hotchk155/gate_boost/gate_boost.sch

## EAGLE design gate_boost.sch (2019-02-27)

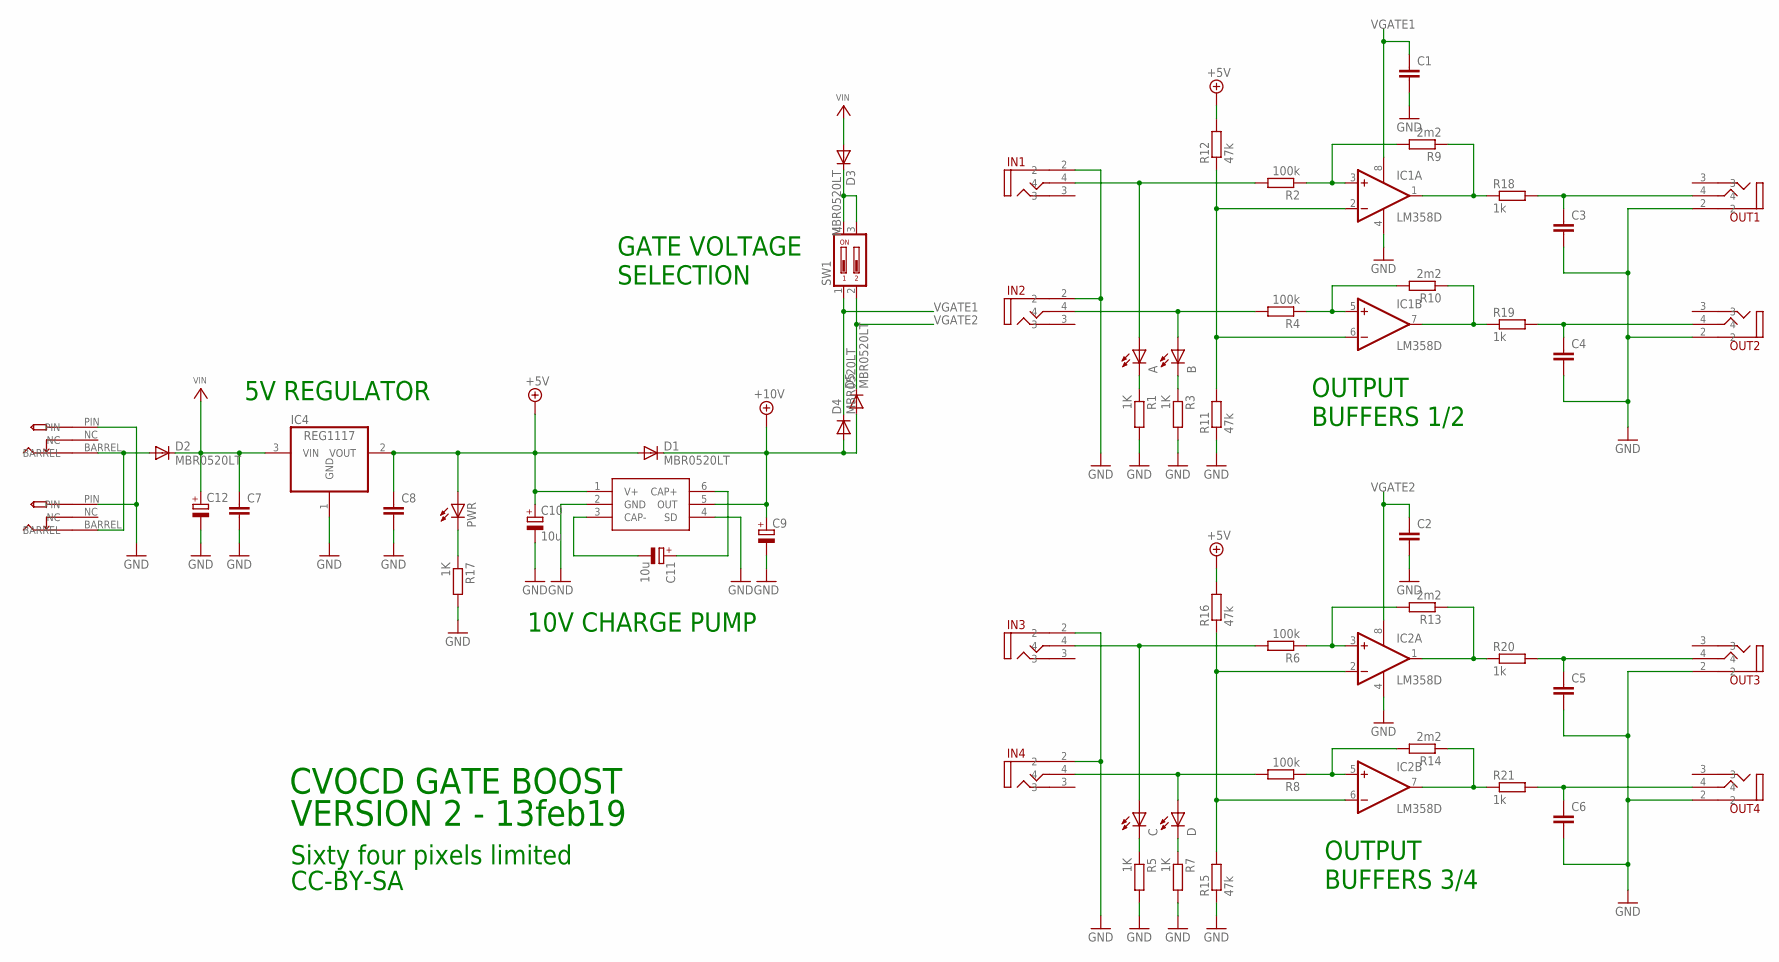
[picture p1: schematic gate_boost.sch]

Parts:
A: LED3MM
B: LED3MM
C: LED3MM
C1, C2, C3, C4, C5, C6, C7, C8: C-EUC0805; C0805
C9: CPOL-EUSMCA; SMC_A
C10, C11: 10u; SMC_A
C12: CPOL-EUE2-5; E2-5
D: LED3MM
D1, D2, D3, D4, D5: MBR0520LT; SOD123
IC1, IC2: LM358D; SO08
IC3: LM27675M5_CHARGEPUMP; SOT23-6
IC4: REG1117; SOT223
IN1, IN2, IN3, IN4: VERTICAL_3_5MM_SOCKET
OUT1, OUT2, OUT3, OUT4: VERTICAL_3_5MM_SOCKET
PWR: LED3MM
R1, R3, R5, R7, R17: 1K; R0805
R2, R4, R6, R8: 100k; R0805
R9, R10, R13, R14: 2m2; R0805
R11, R12, R15, R16: 47k; R0805
R18, R19, R20, R21: 1k; R0805
SW1: DIP02YL
U$1, U$2: PWR_SOCKET_2_1MM

Connections:
+5V: C8.1, C10.+, D1.A, IC3.1 (V+), IC4.2 (VOUT), PWR.A, R12.2, R16.2
+10V: C9.+, D1.C, D4.A, D5.A, IC3.5 (OUT)
GND: C1.2, C2.2, C3.2, C4.2, C5.2, C6.2, C7.2, C8.2, C9.-, C10.-, C12.-, IC1.4 (V-), IC2.4 (V-), IC3.2 (GND), IC3.4 (SD), IC4.1 (GND), IN1.2, IN2.2, IN3.2, IN4.2, OUT1.2, OUT2.2, OUT3.2, OUT4.2, R1.2, R3.2, R5.2, R7.2, R11.1, R15.1, R17.2, U$1.PIN, U$2.PIN
IN1: A.A, IN1.4, R2.2
IN2: B.A, IN2.4, R4.2
IN3: C.A, IN3.4, R6.2
IN4: D.A, IN4.4, R8.2
unnamed: IC1.2 (-IN), IC1.6 (-IN), R11.2, R12.1
unnamed: A.K (C), R1.1
unnamed: B.K (C), R3.1
unnamed: IC1.3 (+IN), R2.1, R9.2
unnamed: IC1.5 (+IN), R4.1, R10.2
unnamed: D3.C, SW1.3, SW1.4
unnamed: C5.1, OUT3.4, R20.2
unnamed: C6.1, OUT4.4, R21.2
unnamed: IC1.1 (OUT), R9.1, R18.1
unnamed: IC2.7 (OUT), R14.1, R21.1
unnamed: IC2.1 (OUT), R13.1, R20.1
unnamed: IC1.7 (OUT), R10.1, R19.1
unnamed: IC2.2 (-IN), IC2.6 (-IN), R15.2, R16.1
unnamed: C.K (C), R5.1
unnamed: D.K (C), R7.1
unnamed: IC2.3 (+IN), R6.1, R13.2
unnamed: IC2.5 (+IN), R8.1, R14.2
unnamed: C3.1, OUT1.4, R18.2
unnamed: C4.1, OUT2.4, R19.2
unnamed: D2.A, U$1.BARREL, U$2.BARREL
unnamed: PWR.K (C), R17.1
unnamed: C11.+, IC3.6 (CAP+)
unnamed: C11.-, IC3.3 (CAP-)
VGATE1: C1.1, D4.C, IC1.8 (V+), SW1.1
VGATE2: C2.1, D5.C, IC2.8 (V+), SW1.2
VIN: C7.1, C12.+, D2.C, D3.A, IC4.3 (VIN)

Notes on the sheet:
10V CHARGE PUMP
CVOCD GATE BOOST
VERSION 2 - 13feb19
Sixty four pixels limited
CC-BY-SA
5V REGULATOR
GATE VOLTAGE SELECTION
OUTPUT BUFFERS 1/2
OUTPUT BUFFERS 3/4
