hotchk155/gate_boost/stencil/gate_boost_stencil.brd

## EAGLE design stencil/gate_boost_stencil.brd (2019-03-22)

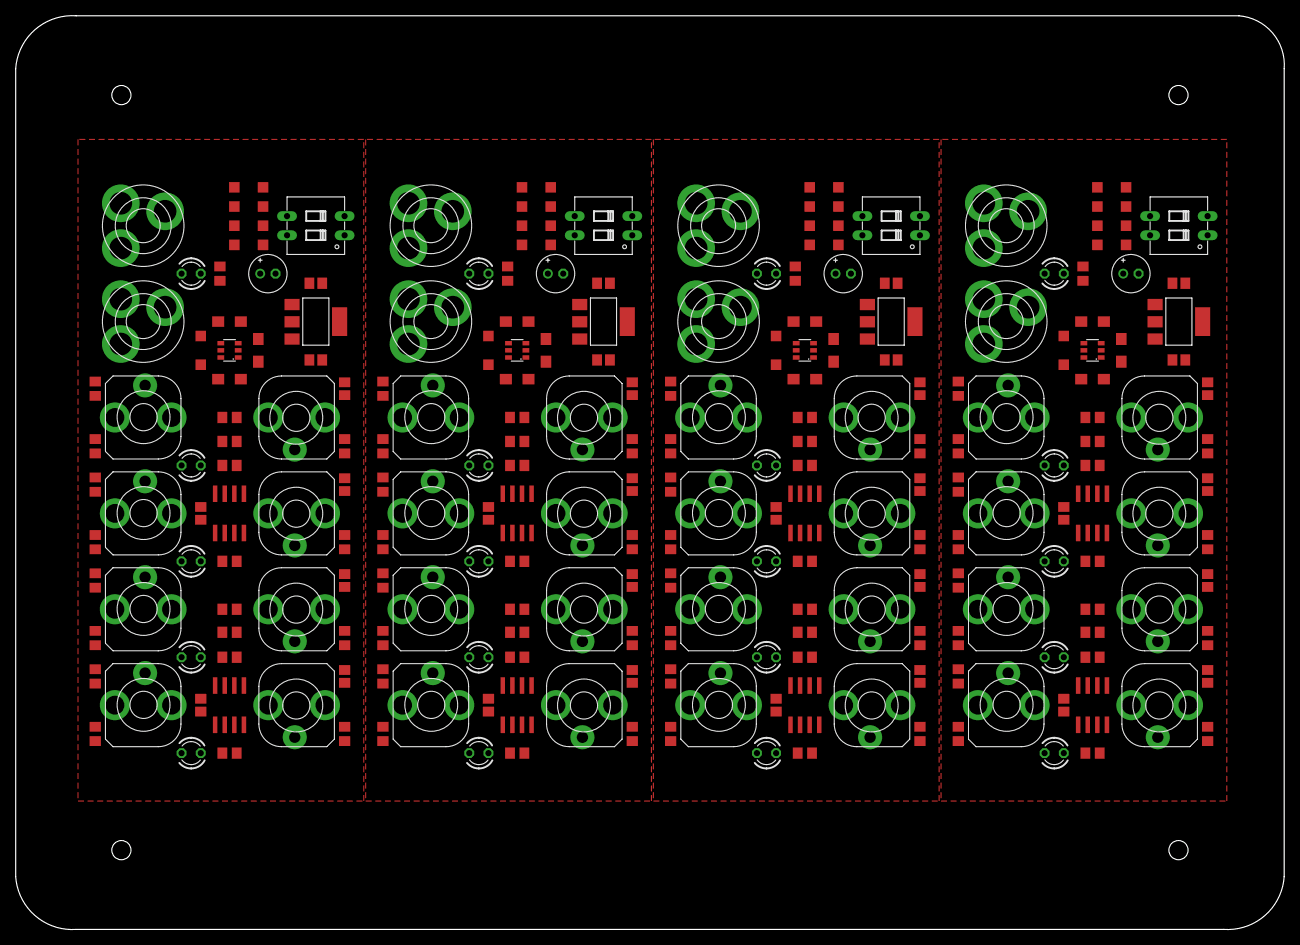
[picture p3: board gate_boost_stencil.brd from above]

Board: 2 copper layers, 168.0 x 121.0 mm, 236 parts (0 on the bottom side), 132 nets, no tracks yet.

Parts:
A, A1, A2, A3: LED3MM
B, B1, B2, B3: LED3MM
C, C19, C32, C45: LED3MM
C1, C2, C3, C4, C5, C6, C7, C8, C13, C14, C18, C20, C21, C22, C24, C25, C26, C27, C31, C33, C34, C35, C37, C38, C39, C40, C44, C46, C47, C48, C50, C51: C0805
C9, C16, C29, C42: SMC_A
C10, C11, C15, C17, C28, C30, C41, C43: 10u; SMC_A
C12, C23, C36, C49: E2-5
D, D7, D13, D19: LED3MM
D1, D2, D3, D4, D5, D6, D8, D9, D10, D11, D12, D14, D15, D16, D17, D18, D20, D21, D22, D23: MBR0520LT; SOD123
E$4, E$5, E$6, E$7: STENCILPIN
IC1, IC2, IC6, IC7, IC10, IC11, IC14, IC15: LM358D; SO08
IC3, IC5, IC9, IC13: LM27675M5_CHARGEPUMP; SOT23-6
IC4, IC8, IC12, IC16: REG1117; SOT223
IN1, IN2, IN3, IN4, IN5, IN6, IN7, IN8, IN9, IN10, IN11, IN12, IN13, IN14, IN15, IN16: VERTICAL_3_5MM_SOCKET
OUT1, OUT2, OUT3, OUT4, OUT5, OUT6, OUT7, OUT8, OUT9, OUT10, OUT11, OUT12, OUT13, OUT14, OUT15, OUT16: VERTICAL_3_5MM_SOCKET
PWR, PWR1, PWR2, PWR3: LED3MM
R1, R3, R5, R7, R17, R22, R23, R32, R33, R42, R43, R44, R53, R54, R63, R64, R65, R74, R75, R84: 1K; R0805
R2, R4, R6, R8, R28, R29, R38, R39, R49, R50, R59, R60, R70, R71, R80, R81: 100k; R0805
R9, R10, R13, R14, R30, R31, R40, R41, R51, R52, R61, R62, R72, R73, R82, R83: 2m2; R0805
R11, R12, R15, R16, R26, R27, R36, R37, R47, R48, R57, R58, R68, R69, R78, R79: 47k; R0805
R18, R19, R20, R21, R24, R25, R34, R35, R45, R46, R55, R56, R66, R67, R76, R77: 1k; R0805
SW1, SW2, SW3, SW4: DIP02YL
U$1, U$2, U$3, U$4, U$5, U$6, U$7, U$8: PWR_SOCKET_2_1MM

Connections:
+5V: C8.1, C10.+, D1.A, IC3.1, IC4.2, PWR.A, R12.2, R16.2
+5V1: C17.+, C25.1, D6.A, IC5.1, IC8.2, PWR1.A, R27.2, R37.2
+5V2: C30.+, C38.1, D12.A, IC9.1, IC12.2, PWR2.A, R48.2, R58.2
+5V3: C43.+, C51.1, D18.A, IC13.1, IC16.2, PWR3.A, R69.2, R79.2
+10V: C9.+, D1.C, D4.A, D5.A, IC3.5
+10V1: C16.+, D6.C, D9.A, D10.A, IC5.5
+10V2: C29.+, D12.C, D15.A, D16.A, IC9.5
+10V3: C42.+, D18.C, D21.A, D22.A, IC13.5
GND: C1.2, C2.2, C3.2, C4.2, C5.2, C6.2, C7.2, C8.2, C9.-, C10.-, C12.-, IC1.4, IC2.4, IC3.2, IC3.4, IC4.1, IN1.2, IN2.2, IN3.2, IN4.2, OUT1.2, OUT2.2, OUT3.2, OUT4.2, R1.2, R3.2, R5.2, R7.2, R11.1, R15.1, R17.2, U$1.PIN, U$2.PIN
GND1: C13.2, C14.2, C16.-, C17.-, C18.2, C20.2, C21.2, C22.2, C23.-, C24.2, C25.2, IC5.2, IC5.4, IC6.4, IC7.4, IC8.1, IN5.2, IN6.2, IN7.2, IN8.2, OUT5.2, OUT6.2, OUT7.2, OUT8.2, R22.2, R23.2, R26.1, R32.2, R33.2, R36.1, R42.2, U$3.PIN, U$4.PIN
GND2: C26.2, C27.2, C29.-, C30.-, C31.2, C33.2, C34.2, C35.2, C36.-, C37.2, C38.2, IC9.2, IC9.4, IC10.4, IC11.4, IC12.1, IN9.2, IN10.2, IN11.2, IN12.2, OUT9.2, OUT10.2, OUT11.2, OUT12.2, R43.2, R44.2, R47.1, R53.2, R54.2, R57.1, R63.2, U$5.PIN, U$6.PIN
GND3: C39.2, C40.2, C42.-, C43.-, C44.2, C46.2, C47.2, C48.2, C49.-, C50.2, C51.2, IC13.2, IC13.4, IC14.4, IC15.4, IC16.1, IN13.2, IN14.2, IN15.2, IN16.2, OUT13.2, OUT14.2, OUT15.2, OUT16.2, R64.2, R65.2, R68.1, R74.2, R75.2, R78.1, R84.2, U$7.PIN, U$8.PIN
IN1: A.A, IN1.4, R2.2
IN2: B.A, IN2.4, R4.2
IN3: C.A, IN3.4, R6.2
IN4: D.A, IN4.4, R8.2
IN5: C19.A, IN7.4, R38.2
IN6: D7.A, IN8.4, R39.2
IN7: A1.A, IN5.4, R28.2
IN8: B1.A, IN6.4, R29.2
IN9: C32.A, IN11.4, R59.2
IN10: D13.A, IN12.4, R60.2
IN11: A2.A, IN9.4, R49.2
IN12: B2.A, IN10.4, R50.2
IN13: C45.A, IN15.4, R80.2
IN14: D19.A, IN16.4, R81.2
IN15: A3.A, IN13.4, R70.2
IN16: B3.A, IN14.4, R71.2
unnamed: IC1.2, IC1.6, R11.2, R12.1
unnamed: A.K, R1.1
unnamed: B.K, R3.1
unnamed: IC1.3, R2.1, R9.2
unnamed: IC1.5, R4.1, R10.2
unnamed: D3.C, SW1.3, SW1.4
unnamed: C5.1, OUT3.4, R20.2
unnamed: C6.1, OUT4.4, R21.2
unnamed: IC1.1, R9.1, R18.1
unnamed: IC2.7, R14.1, R21.1
unnamed: IC2.1, R13.1, R20.1
unnamed: IC1.7, R10.1, R19.1
unnamed: IC2.2, IC2.6, R15.2, R16.1
unnamed: C.K, R5.1
unnamed: D.K, R7.1
unnamed: IC2.3, R6.1, R13.2
unnamed: IC2.5, R8.1, R14.2
unnamed: C13.1, OUT5.4, R24.2
unnamed: C3.1, OUT1.4, R18.2
unnamed: C4.1, OUT2.4, R19.2
unnamed: D2.A, U$1.BARREL, U$2.BARREL
unnamed: C14.1, OUT6.4, R25.2
unnamed: PWR.K, R17.1
unnamed: IC6.7, R25.1, R30.1
unnamed: IC6.1, R24.1, R31.1
unnamed: C15.+, IC5.6
unnamed: C15.-, IC5.3
unnamed: IC6.2, IC6.6, R26.2, R27.1
unnamed: A1.K, R23.1
unnamed: B1.K, R22.1
unnamed: IC6.3, R28.1, R31.2
unnamed: IC6.5, R29.1, R30.2
unnamed: C20.1, OUT7.4, R34.2
unnamed: C21.1, OUT8.4, R35.2
unnamed: IC7.7, R35.1, R40.1
unnamed: IC7.1, R34.1, R41.1
unnamed: IC7.2, IC7.6, R36.2, R37.1
unnamed: C11.+, IC3.6
unnamed: C11.-, IC3.3
unnamed: C19.K, R33.1
unnamed: D7.K, R32.1
unnamed: IC7.3, R38.1, R41.2
unnamed: IC7.5, R39.1, R40.2
unnamed: D8.A, U$3.BARREL, U$4.BARREL
unnamed: PWR1.K, R42.1
unnamed: D11.C, SW2.3, SW2.4
unnamed: C26.1, OUT9.4, R45.2
unnamed: C27.1, OUT10.4, R46.2
unnamed: IC10.7, R46.1, R51.1
unnamed: IC10.1, R45.1, R52.1
unnamed: C28.+, IC9.6
unnamed: C28.-, IC9.3
unnamed: IC10.2, IC10.6, R47.2, R48.1
unnamed: A2.K, R44.1
unnamed: B2.K, R43.1
unnamed: IC10.3, R49.1, R52.2
unnamed: IC10.5, R50.1, R51.2
unnamed: C33.1, OUT11.4, R55.2
unnamed: C34.1, OUT12.4, R56.2
unnamed: IC11.7, R56.1, R61.1
unnamed: IC11.1, R55.1, R62.1
unnamed: IC11.2, IC11.6, R57.2, R58.1
unnamed: C32.K, R54.1
unnamed: D13.K, R53.1
unnamed: IC11.3, R59.1, R62.2
unnamed: IC11.5, R60.1, R61.2
unnamed: D14.A, U$5.BARREL, U$6.BARREL
unnamed: PWR2.K, R63.1
unnamed: D17.C, SW3.3, SW3.4
unnamed: C39.1, OUT13.4, R66.2
unnamed: C40.1, OUT14.4, R67.2
unnamed: IC14.7, R67.1, R72.1
unnamed: IC14.1, R66.1, R73.1
unnamed: C41.+, IC13.6
unnamed: C41.-, IC13.3
unnamed: IC14.2, IC14.6, R68.2, R69.1
unnamed: A3.K, R65.1
unnamed: B3.K, R64.1
unnamed: IC14.3, R70.1, R73.2
unnamed: IC14.5, R71.1, R72.2
unnamed: C46.1, OUT15.4, R76.2
unnamed: C47.1, OUT16.4, R77.2
unnamed: IC15.7, R77.1, R82.1
unnamed: IC15.1, R76.1, R83.1
unnamed: IC15.2, IC15.6, R78.2, R79.1
unnamed: C45.K, R75.1
unnamed: D19.K, R74.1
unnamed: IC15.3, R80.1, R83.2
unnamed: IC15.5, R81.1, R82.2
unnamed: D20.A, U$7.BARREL, U$8.BARREL
unnamed: PWR3.K, R84.1
unnamed: D23.C, SW4.3, SW4.4
VGATE1: C1.1, D4.C, IC1.8, SW1.1
VGATE2: C2.1, D5.C, IC2.8, SW1.2
VGATE3: C22.1, D10.C, IC7.8, SW2.2
VGATE4: C18.1, D9.C, IC6.8, SW2.1
VGATE5: C35.1, D16.C, IC11.8, SW3.2
VGATE6: C31.1, D15.C, IC10.8, SW3.1
VGATE7: C48.1, D22.C, IC15.8, SW4.2
VGATE8: C44.1, D21.C, IC14.8, SW4.1
VIN: C7.1, C12.+, D2.C, D3.A, IC4.3
VIN1: C23.+, C24.1, D8.C, D11.A, IC8.3
VIN2: C36.+, C37.1, D14.C, D17.A, IC12.3
VIN3: C49.+, C50.1, D20.C, D23.A, IC16.3
