hotchk155/gate_boost/(commit log)

2019-01-10 prior change to charge pump
    [gate_boost.brd, gate_boost.sch]
2019-01-10 charge pump
    [gate_boost.brd, gate_boost.sch]
2019-01-10 getting there
    [gate_boost.brd, gate_boost.sch]
2019-01-28 component values
    [gate_boost.brd, gate_boost.sch]
2019-02-27 V2 additional schottky on VIN
    [gate_boost.brd, gate_boost.sch]
2019-02-27 tidy tidy
    [gate_boost.brd, gate_boost.sch]
2019-02-27 Update gate_boost_panel.brd
    das
    [gate_boost_panel.brd]
2022-01-12 V1 of PCB for front panel
    [drawing.kicad_pcb, kicad_export.kicad_pcb]
2022-03-07 Update gate boost BOM.txt
2022-03-07 red LEDs
